piermatt/ElectroSummer2026/Schematic_electro_summer_potentiostat_lm_2026-09-22.pdf

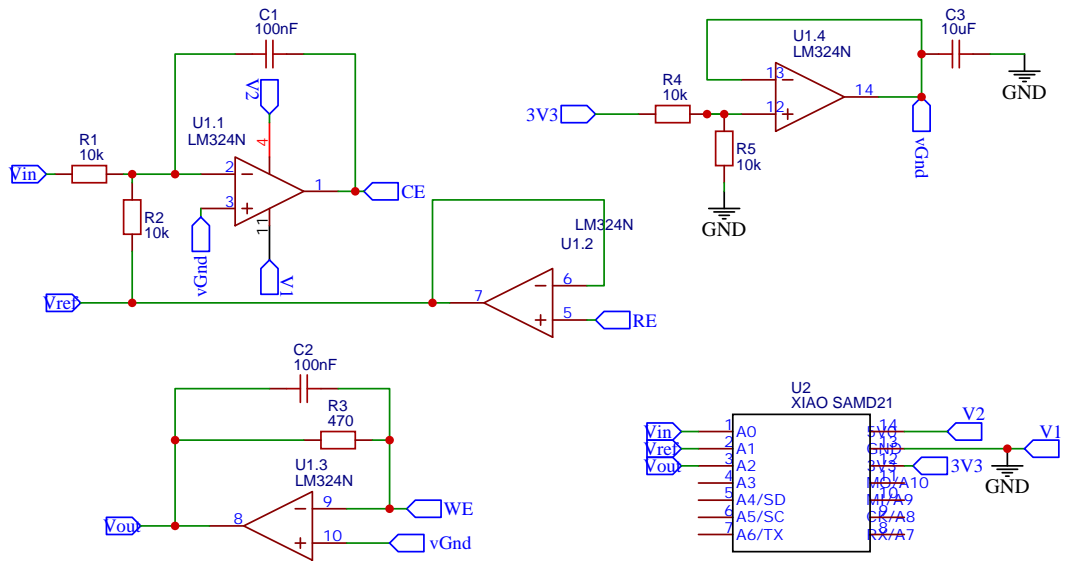
[picture p3: page 1]

Drawn By: mattia pierpaoli
